CDRKPro/CK-Pro/dozr-3d/boutique/LISEZMOI.md

Page boutique Dozr publiée en artifact. Le modèle 3D (`dozr_web.json`) est celui de `../web/`.
