CDRKPro/CK-Pro/ck-video/VOIX.md

# Texte de la voix off — CK Web Designer (44 s)

Ton : posé, chaleureux, confiant. Environ 2,5 mots par seconde.

| Début | Texte |
|---|---|
| 0:00 | Aujourd'hui, vos futurs clients vous cherchent en ligne. |
| 0:04.6 | Avec CK Web Designer… |
| 0:07.4 | on crée la vitrine digitale de votre entreprise. |
| 0:11.6 | Un site sur mesure, moderne, à votre image. |
| 0:17.0 | Visible sur Google, sur Maps… et même dans ChatGPT. |
| 0:22.6 | Vos visiteurs deviennent des clients. |
| 0:26.4 | Un seul interlocuteur, du début à la fin. |
| 0:30.8 | Site, référencement, maintenance : on s'occupe de tout. |
| 0:35.2 | Envie d'en faire autant ? Réservez votre rendez-vous. |
| 0:39.4 | CK Web Designer. Un site qui vous ressemble. |
