CDRKPro/CK-Pro/ck-video/BRIEF.md

---
workflow: launch
flow: automation
storyboard: no
message: "CK Web Designer crée la vitrine digitale qui fait venir les clients des artisans et commerces."
destination: tiktok-reels
aspect: "9:16"
language: fr
length: ~43s
---

## Intent
Recréer la vidéo de référence (promo Scalyx « Motion design Claude », 16:9 ~38 s) pour CK Web Designer,
aux couleurs et au design de ckwebdesigner.fr. Même déroulé : recherche → logo → vitrine digitale →
réalisations → visible Google/Maps/ChatGPT → visiteurs deviennent clients → preuve → on s'occupe de tout →
CTA rendez-vous → carte de fin.

## Customizations
- Pas de logo/écran TikTok à la fin (demande explicite).
- 9:16 vertical plein écran, sans bandeau titre.
- Scène témoignage « ≈20 prospects » : version sans chiffre, sans faux client → remplacée par la méthode réelle du site (4 étapes).

## Assets
- Captures d'écran du site fournies par Cédric (mobile) : couleurs, polices, textes, prix, réalisations.
- Logo vectorisé depuis la capture (assets/logo.svg).
