CDRKPro/CK-Pro/ck-video/assets/shots/about.jpg

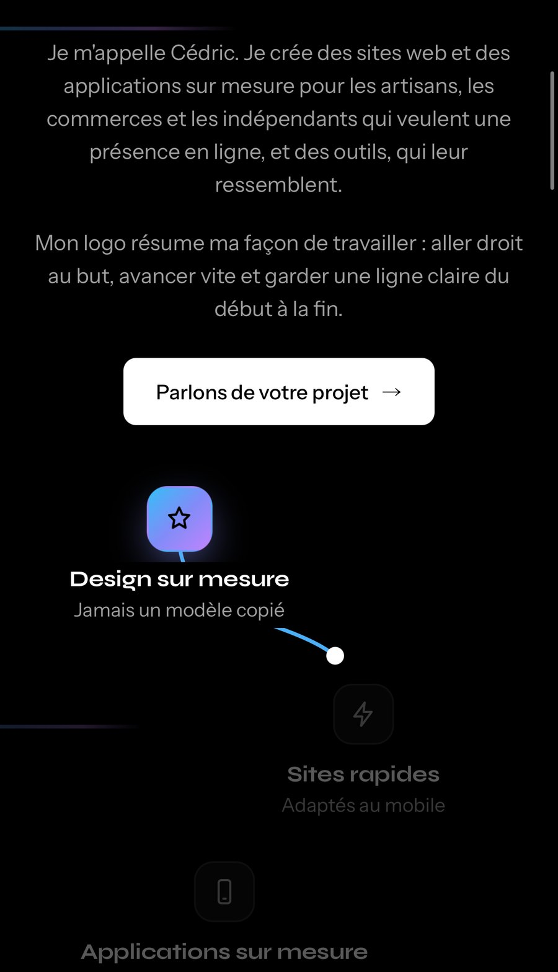
ck-video/assets/shots/about.jpg
