CDRKPro/CK-Pro/ck-video/assets/shots/contact.jpg

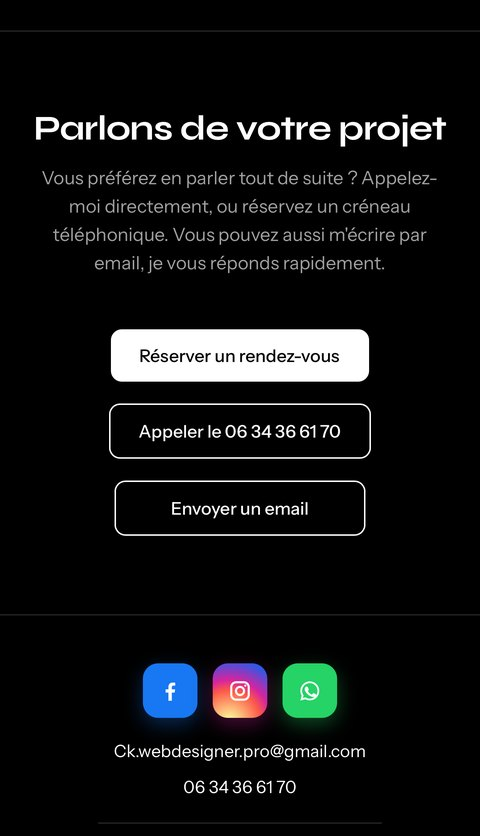
ck-video/assets/shots/contact.jpg
