CDRKPro/CK-Pro/ck-video/assets/shots/demos.jpg

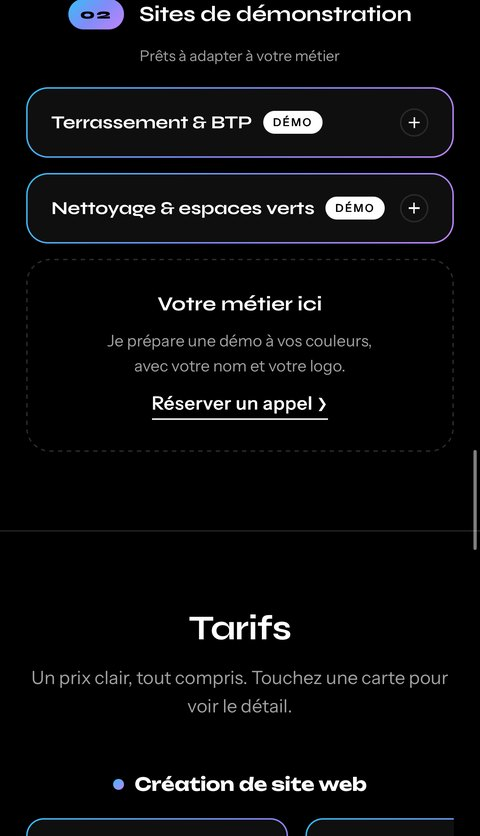
ck-video/assets/shots/demos.jpg
