CDRKPro/CK-Pro/ck-video/assets/shots/estim.jpg

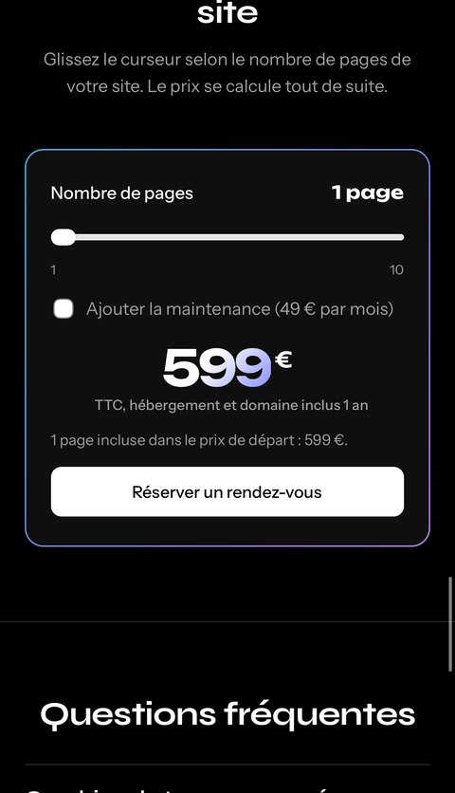
ck-video/assets/shots/estim.jpg
