CDRKPro/CK-Pro/ck-video/assets/shots/form.jpg

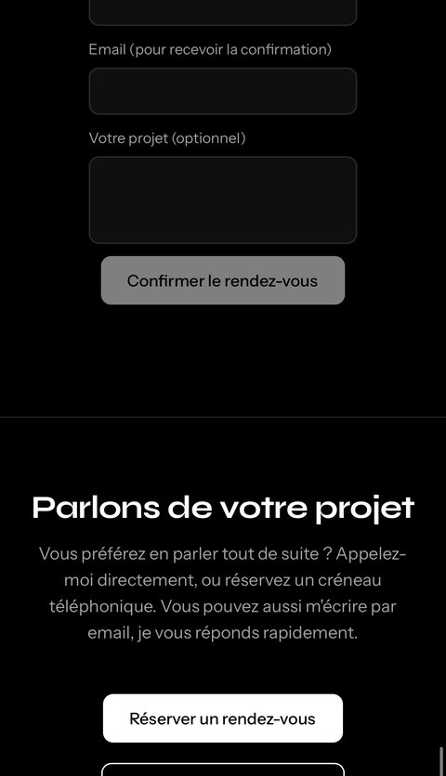
ck-video/assets/shots/form.jpg
