CDRKPro/CK-Pro/ck-video/assets/shots/hero.jpg

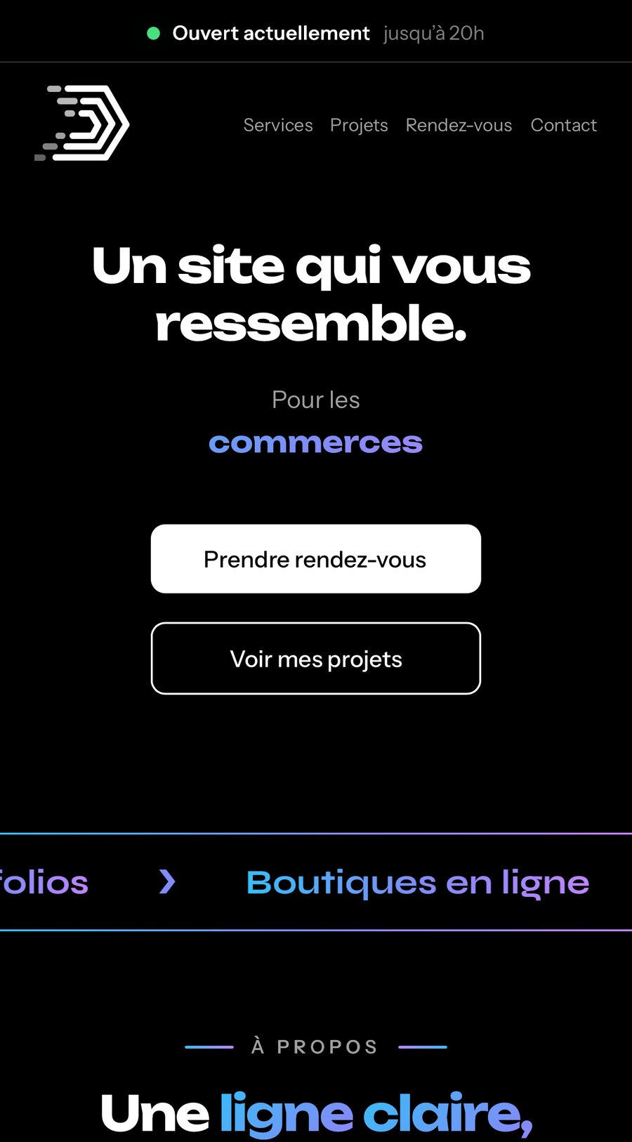
ck-video/assets/shots/hero.jpg
