CDRKPro/CK-Pro/ck-video/assets/shots/method.jpg

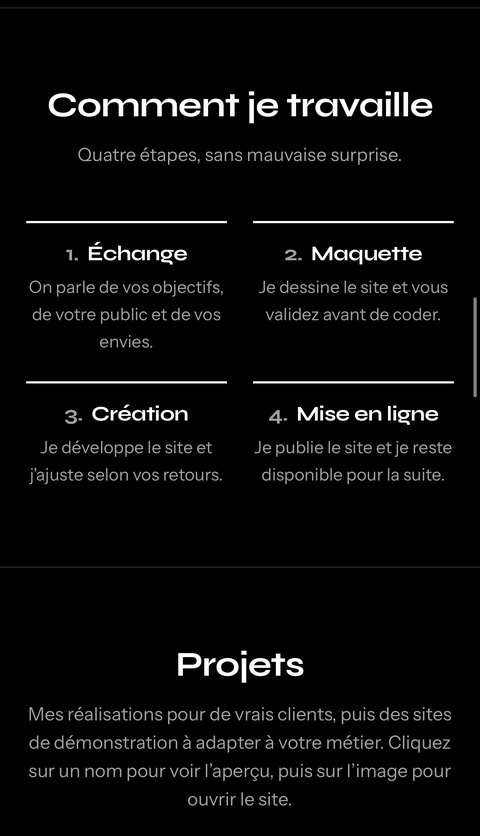
ck-video/assets/shots/method.jpg
