CDRKPro/CK-Pro/ck-video/assets/shots/projets.jpg

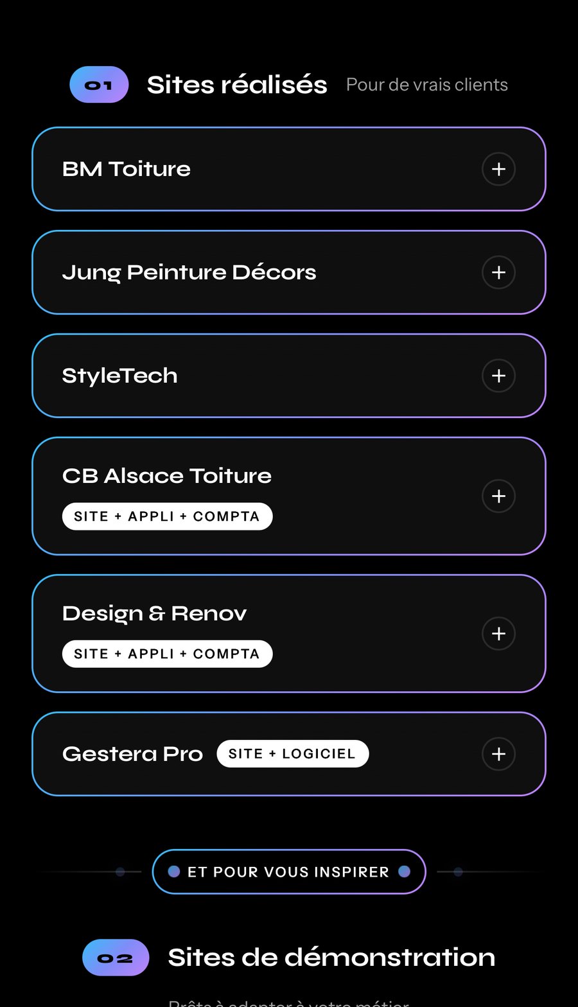
ck-video/assets/shots/projets.jpg
