CDRKPro/CK-Pro/ck-video/assets/shots/rdv.jpg

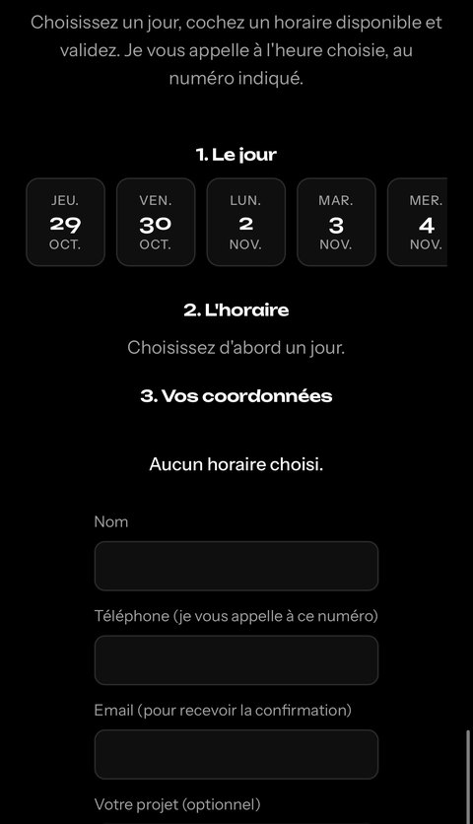
ck-video/assets/shots/rdv.jpg
