CDRKPro/CK-Pro/ck-video/assets/shots/services2.jpg

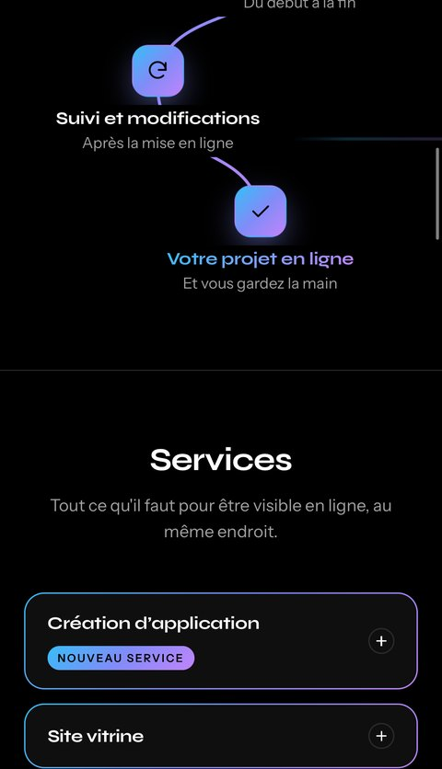
ck-video/assets/shots/services2.jpg
