CDRKPro/CK-Pro/ck-video/assets/shots/services.jpg

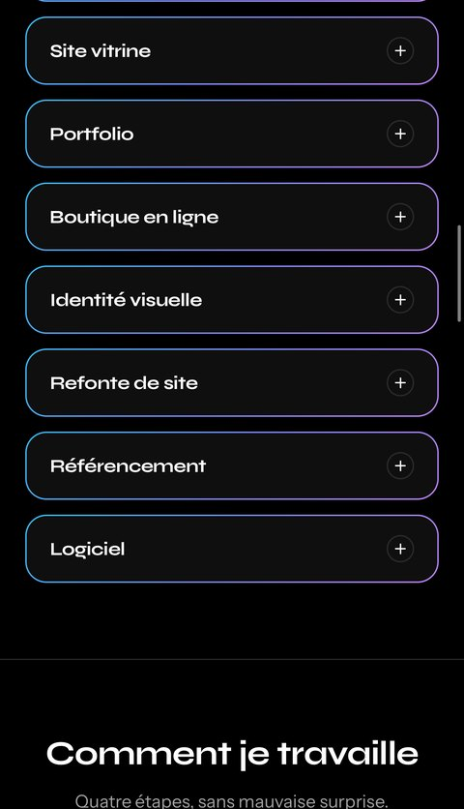
ck-video/assets/shots/services.jpg
