CDRKPro/CK-Pro/ck-video/assets/shots/tarifs2.jpg

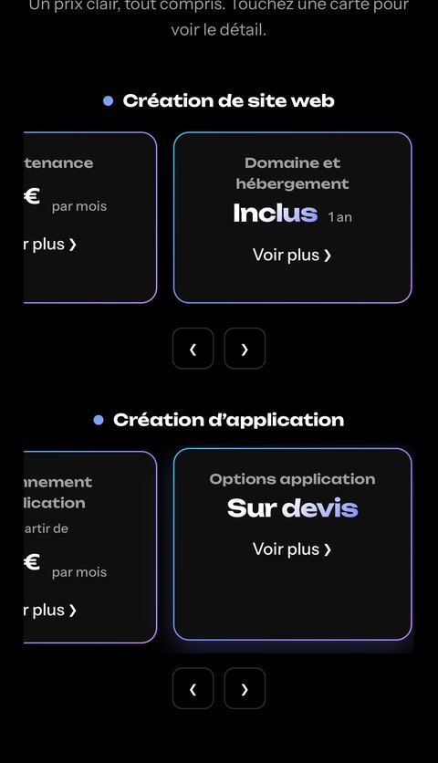
ck-video/assets/shots/tarifs2.jpg
