CDRKPro/CK-Pro/ck-video/assets/shots/tarifs3.jpg

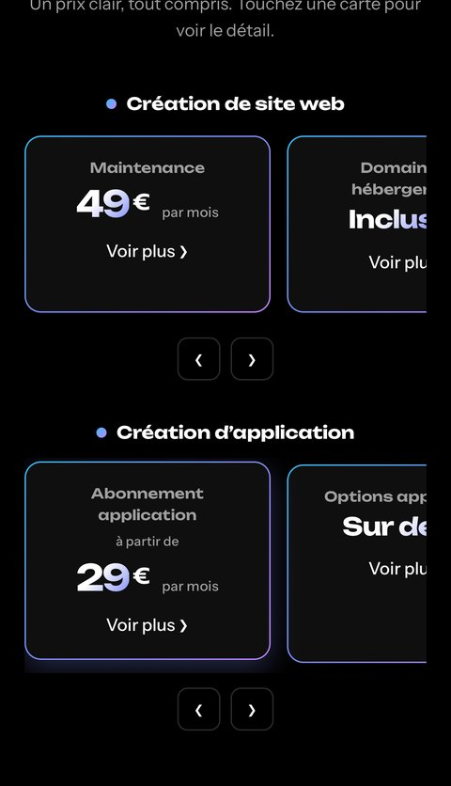
ck-video/assets/shots/tarifs3.jpg
