CDRKPro/CK-Pro/ck-video/assets/shots/tarifs.jpg

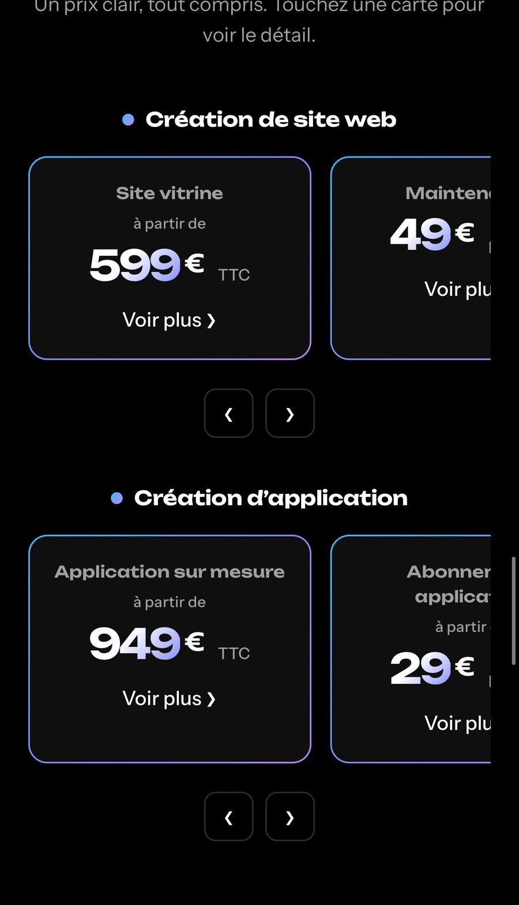
ck-video/assets/shots/tarifs.jpg
