CDRKPro/CK-Pro/ck-video/assets/shots/timeline.jpg

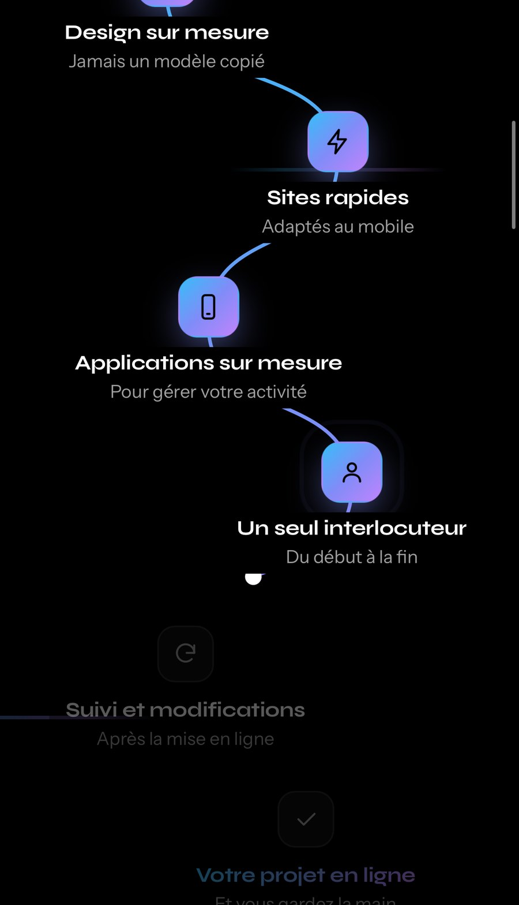
ck-video/assets/shots/timeline.jpg
