CDRKPro/CK-Pro/dozr-3d/boutique/dozr_blanc.png

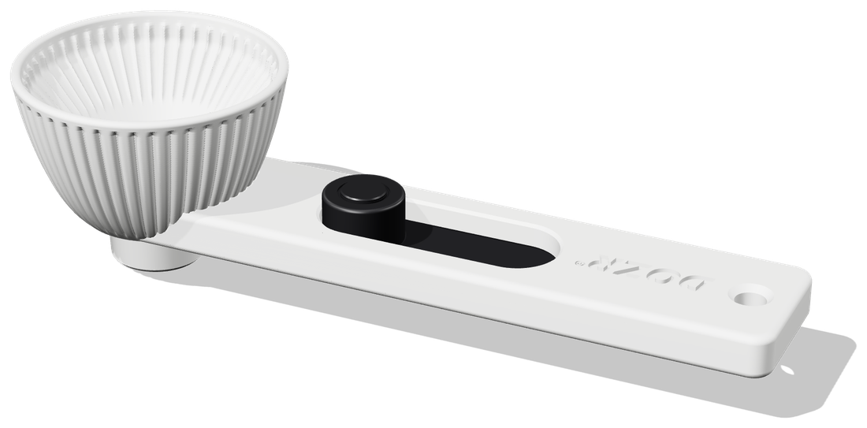
dozr-3d/boutique/dozr_blanc.png
