CDRKPro/CK-Pro/dozr-3d/boutique/dozr_bleu.png

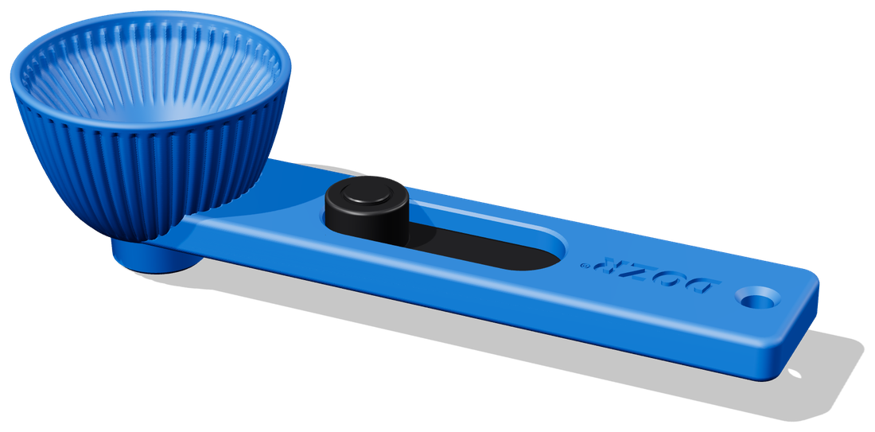
dozr-3d/boutique/dozr_bleu.png
