CDRKPro/CK-Pro/dozr-3d/images/dozr_gamme_couleurs.png

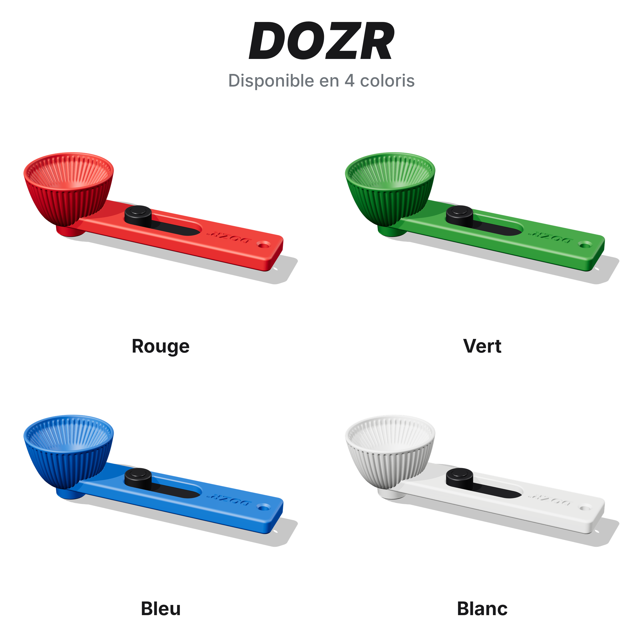
dozr-3d/images/dozr_gamme_couleurs.png
