CDRKPro/CK-Pro/dozr-3d/images/dozr_packshot.png

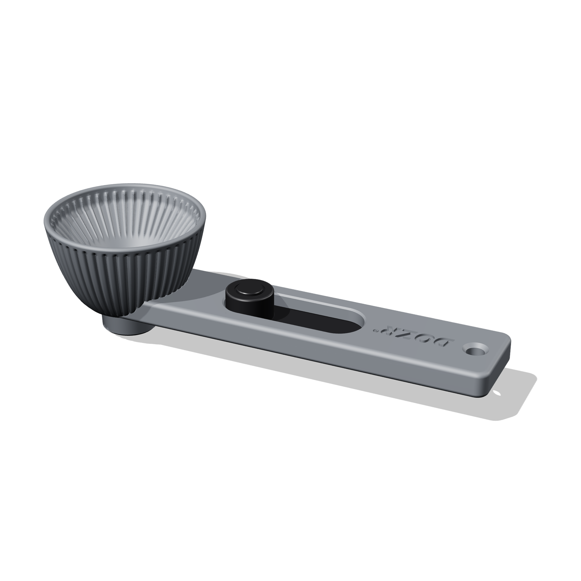
dozr-3d/images/dozr_packshot.png
