CDRKPro/CK-Pro/dozr-3d/images/dozr_visuel.png

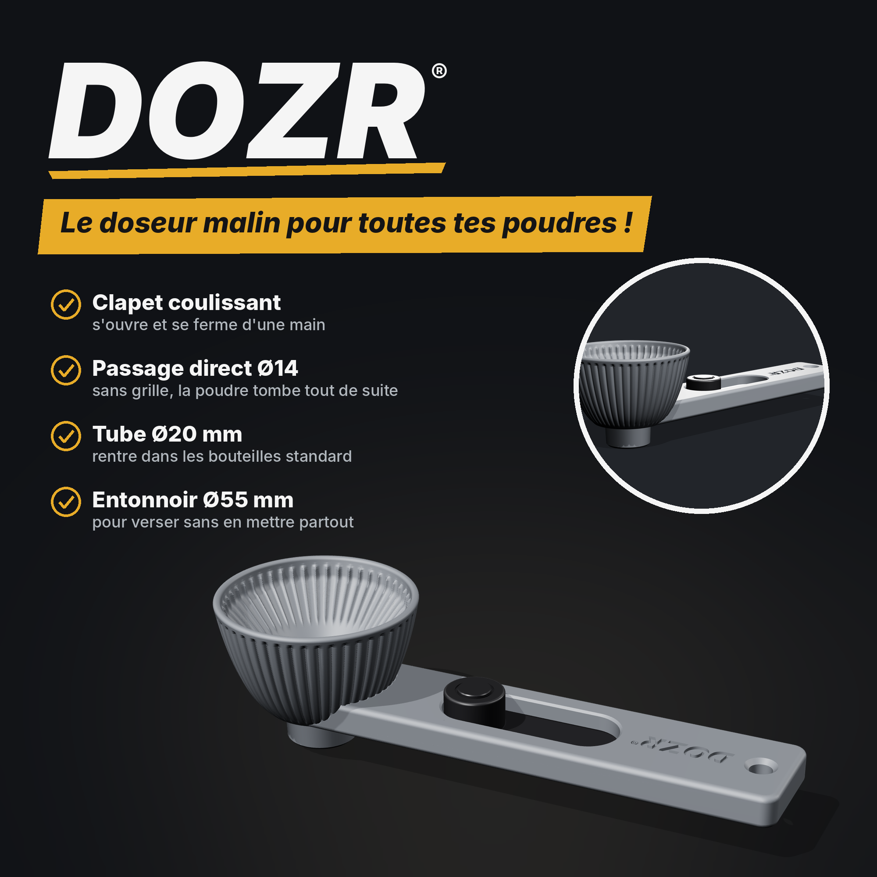
dozr-3d/images/dozr_visuel.png
