CDRKPro/CK-Pro/dozr-3d/plan.png

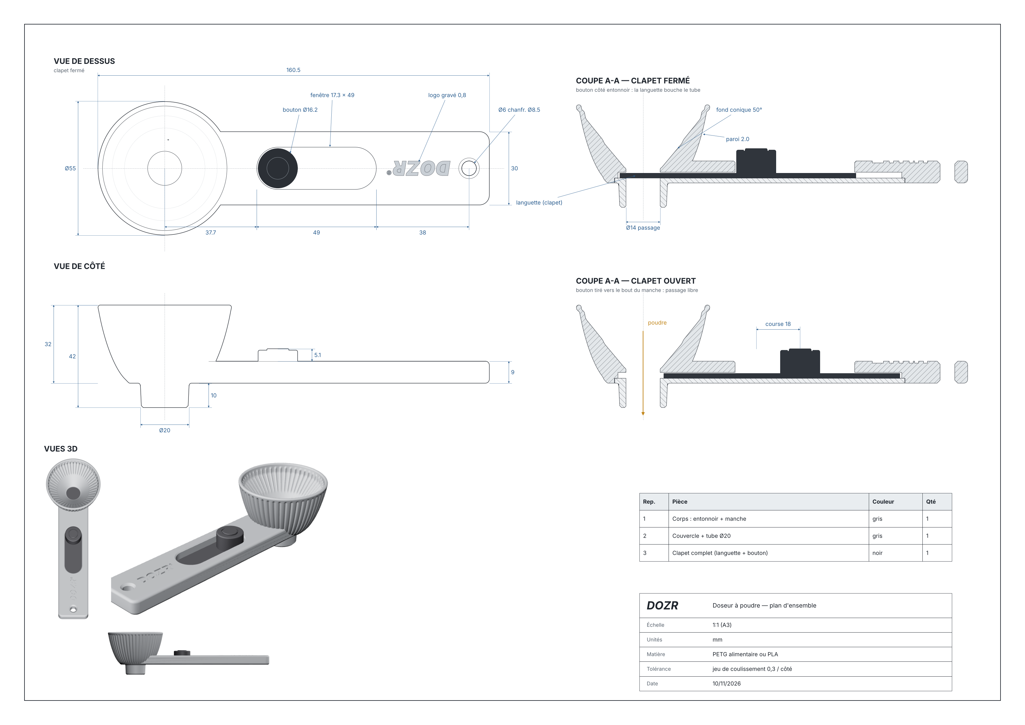
dozr-3d/plan.png
