CDRKPro/CK-Pro/dozr-3d/dozr_assemblage.3mf

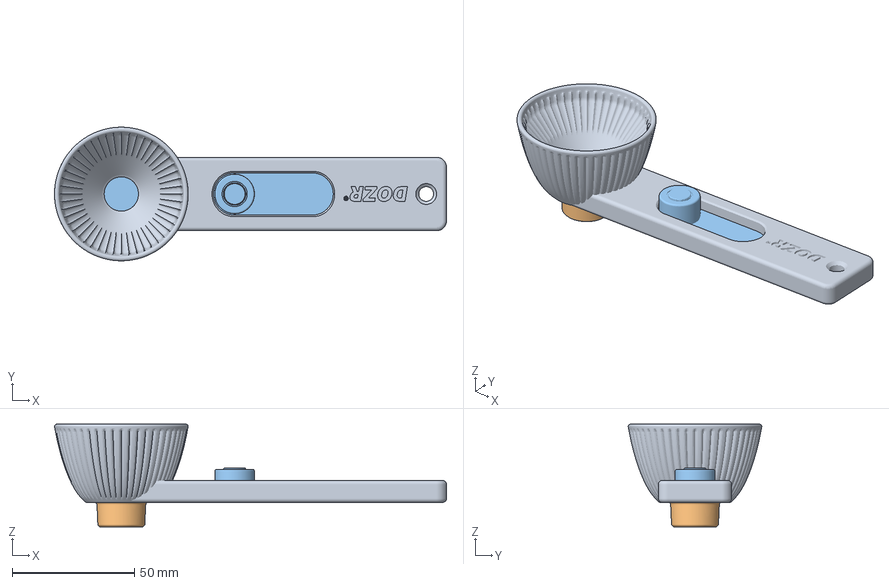
[picture p25: CAD file, 2026-11-10]
dozr-3d/dozr_assemblage.3mf
160.3 x 54.7 x 42.0 mm
corps
couvercle_bec
clapet
