CDRKPro/CK-Pro/dozr-3d/plateau_2_noir.3mf

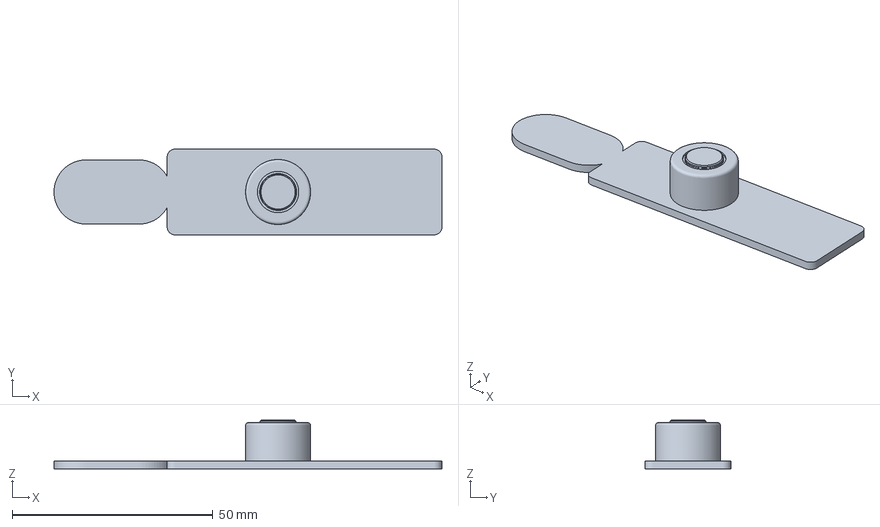
[picture p26: CAD file, 2026-11-10]
dozr-3d/plateau_2_noir.3mf
96.7 x 21.4 x 12.1 mm
