CDRKPro/CK-Pro/dozr-3d/stl/2_couvercle_bec.stl

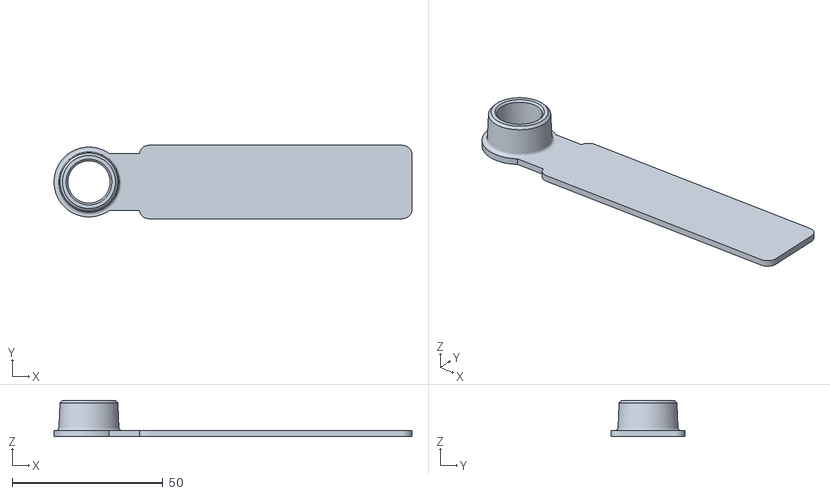
[picture p27: CAD file, 2026-11-10]
dozr-3d/stl/2_couvercle_bec.stl
118.8 x 24.4 x 12.0
