CDRKPro/CK-Pro/dozr-3d/plateau_1_gris.3mf

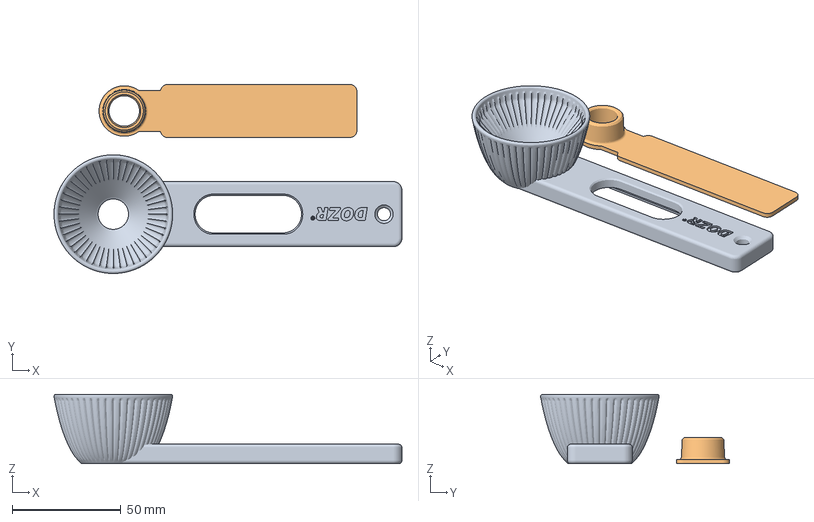
[picture p28: CAD file, 2026-11-10]
dozr-3d/plateau_1_gris.3mf
160.3 x 87.1 x 32.0 mm
1_corps_entonnoir_manche
2_couvercle_bec
