CDRKPro/CK-Pro/dozr-3d/stl/1_corps_entonnoir_manche.stl

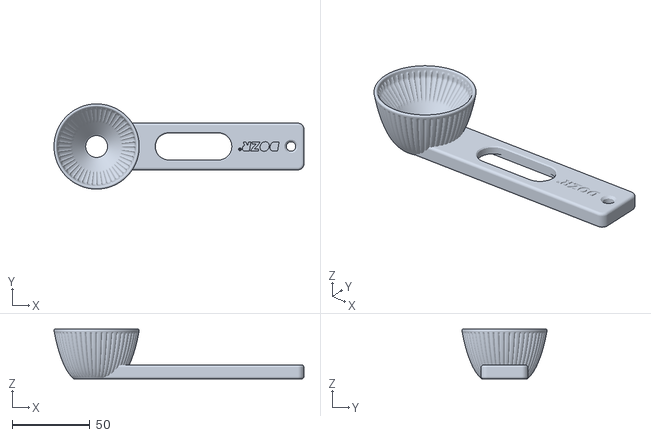
[picture p29: CAD file, 2026-11-10]
dozr-3d/stl/1_corps_entonnoir_manche.stl
160.3 x 54.7 x 32.0
