CDRKPro/CK-Pro/dozr-3d/plateau_complet_multicolore.3mf

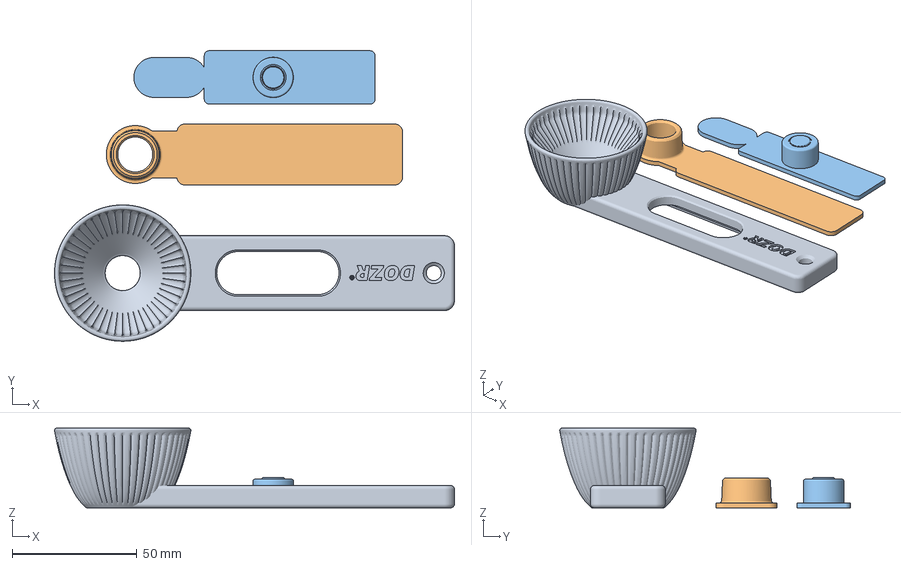
[picture p30: CAD file, 2026-11-10]
dozr-3d/plateau_complet_multicolore.3mf
160.3 x 116.5 x 32.0 mm
1_corps_entonnoir_manche
2_couvercle_bec
3_clapet_complet
