CDRKPro/CK-Pro/(list of files, cad)

Other CAD files:
dozr-3d/stl/3_clapet_complet.stl
dozr-3d/dozr_assemblage.stl
