CDRKPro/CK-Pro/ck-video/assets/shots/faq.jpg

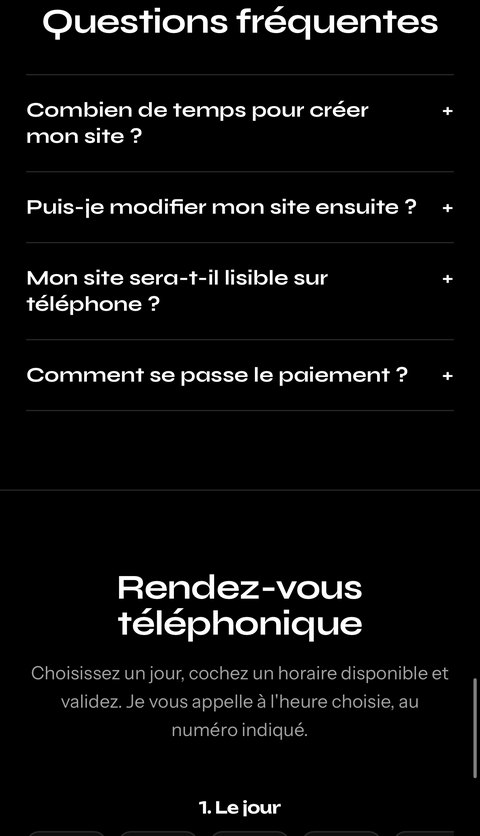
ck-video/assets/shots/faq.jpg
