CDRKPro/CK-Pro/dozr-3d/plan.pdf

## VUE DE DESSUS

## COUPE A-A — CLAPET FERMÉ

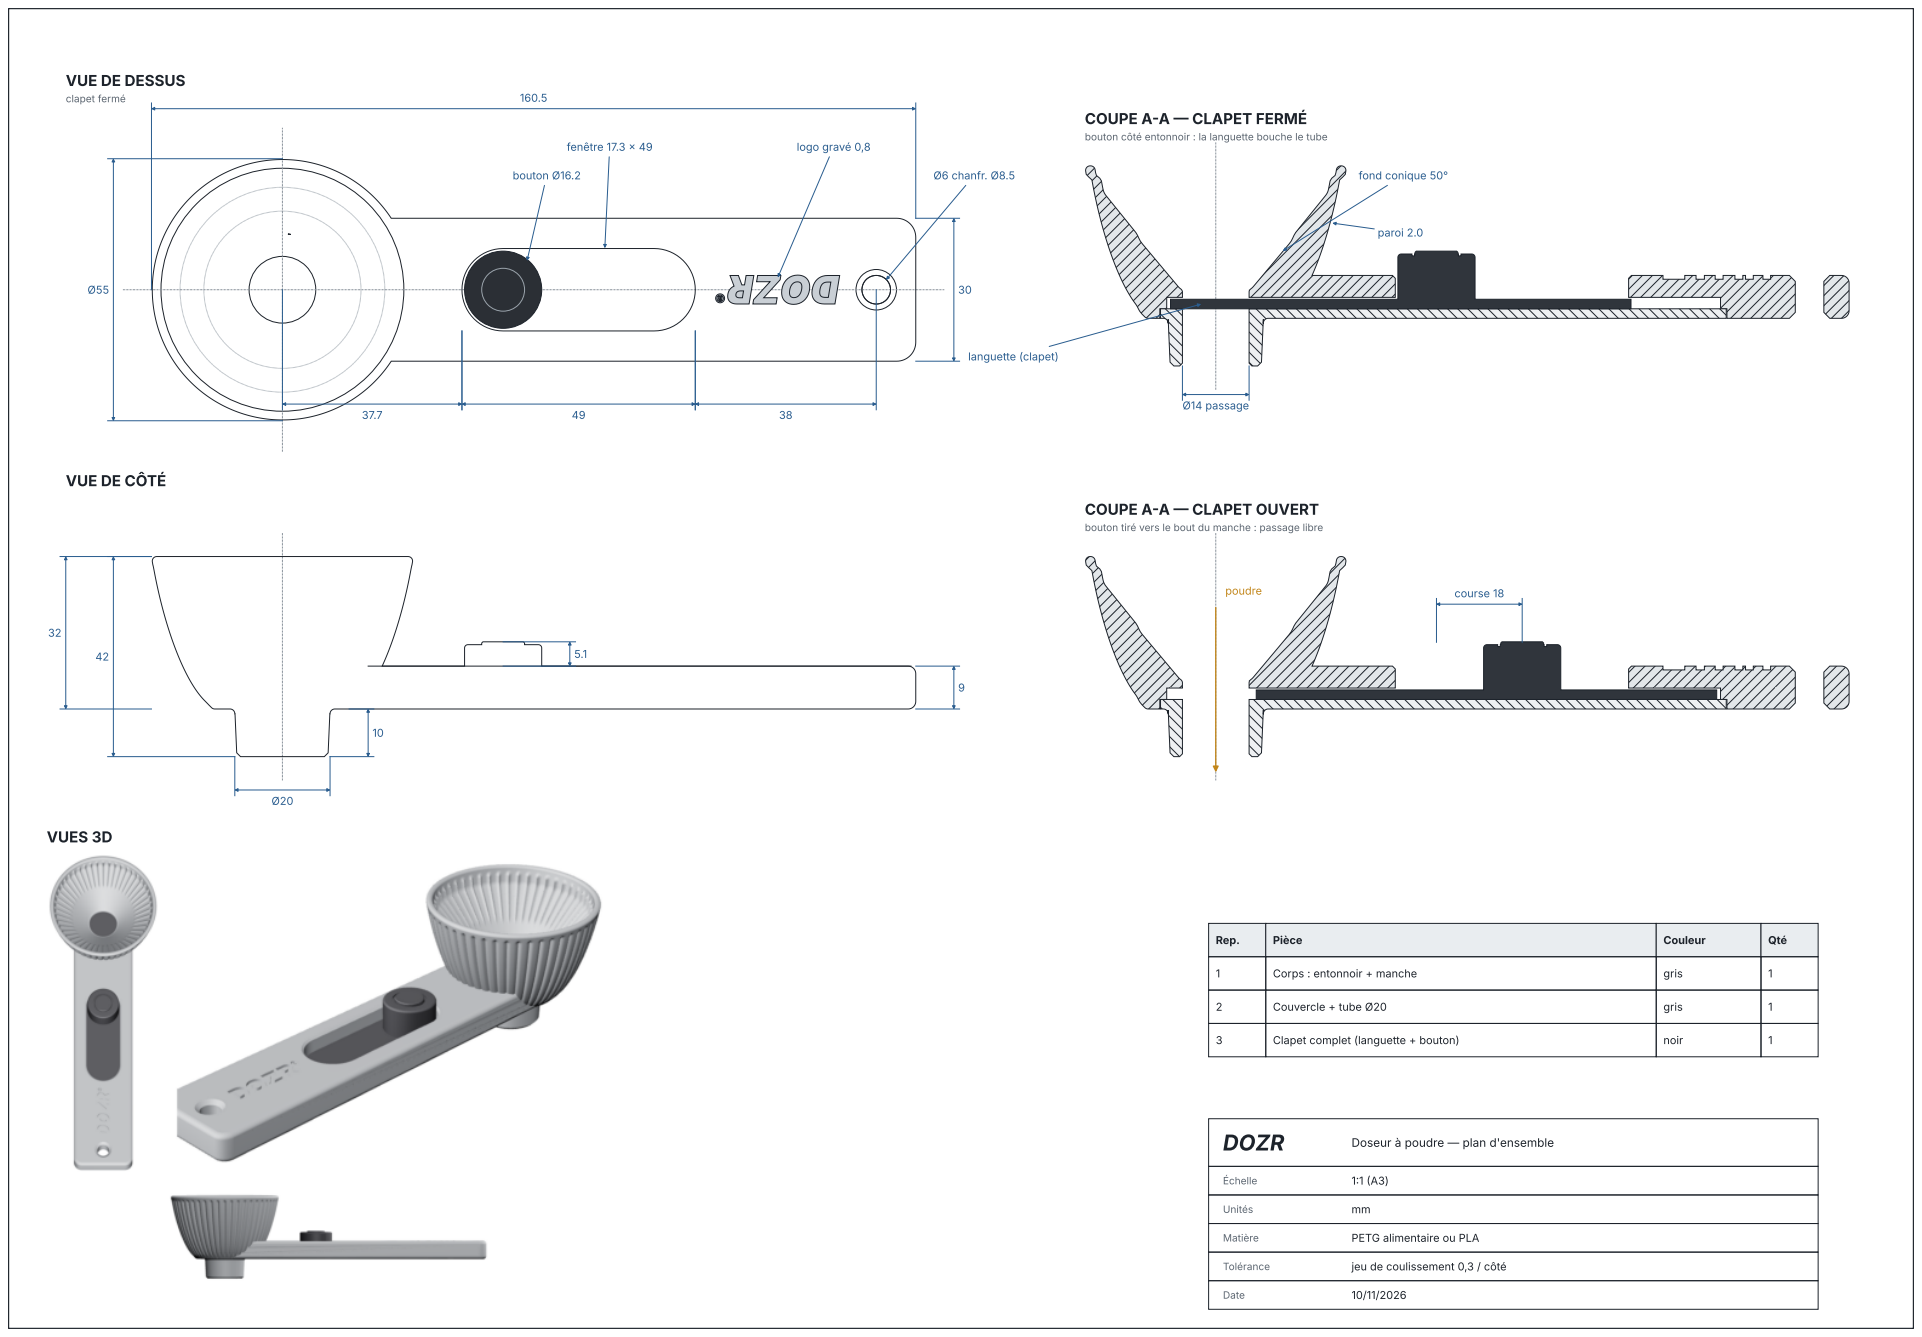
[picture p32: page 1]
clapet fermé; bouton Ø16.2; Ø6 chanfr. Ø8.5; fenêtre 17.3 × 49; logo gravé 0,8; Ø14 passage; fond conique 50°; languette (clapet); paroi 2.0; poudre; course 18; VUES 3D; Rep.; Pièce; Couleur; Qté; Corps : entonnoir + manche; gris; Couvercle + tube Ø20; Clapet complet (languette + bouton); noir; DOZR; Doseur à poudre — plan d'ensemble; Échelle; Unités; Matière; PETG alimentaire ou PLA; Tolérance; jeu de coulissement 0,3 / côté; Date

bouton côté entonnoir : la languette bouche le tube

VUE DE CÔTÉ

COUPE A-A — CLAPET OUVERT

bouton tiré vers le bout du manche : passage libre
