CDRKPro/CK-Pro/(commit log)

2026-10-26 Add Funding Pro prop-firm landing page
    Single-file static page: hero with account dashboard mock, stats,
    interactive challenge picker, steps, features, payout feed,
    sample testimonials, FAQ and footer with risk disclaimer.
    Claude-Session: https://claude.ai/code/session_01TbBw8k7q31zmcosYMwTQGu
2026-11-10 Ajoute le modèle 3D imprimable du doseur Dozr
    Modèle paramétrique (Python + manifold3d) en 5 pièces : corps inférieur avec bec,
    entonnoir cannelé, trappe coulissante, bouton et tamis. STL orientés pour
    l'impression, assemblage 3MF/GLB/STL et notice.
    Claude-Session: https://claude.ai/code/session_013o4PzjrureLHbsufY6pFN3
    [1_corps_inferieur.stl, 2_corps_superieur_entonnoir.stl, 3_trappe_coulissante.stl, 4_bouton.stl, 5_tamis.stl, dozr_assemblage.3mf, dozr_assemblage.stl]
2026-11-10 Dozr : reprend la forme exacte du visuel produit
    Entonnoir évasé cannelé dehors et dedans avec fond arrondi, tamis rond
    affleurant, manche plat 30 mm avec pilule noire et bouton rond côté
    entonnoir, trou de suspension. Languette coulissante cachée sous le fond.
    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
    [1_corps_inferieur.stl, 2_corps_superieur_entonnoir.stl, 3_languette.stl, 3_trappe_coulissante.stl, 4_bouton.stl, 5_tamis.stl, 6_insert_noir.stl, dozr_assemblage.3mf]
2026-11-10 Dozr : modèle calqué sur les vues de face et 3/4
    Proportions relevées sur la vue de face (manche 30 mm, longueur 160,5 mm,
    pilule 17,3 x 49 mm, bouton Ø16 à disque central, trou chanfreiné), profil
    d'après la vue 3/4 : entonnoir Ø55 x 28 à fond très arrondi cannelé dedans
    et dehors, fond plat posé sur le goulot (bec en option).
    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
    [1_corps_inferieur.stl, 2_corps_superieur_entonnoir.stl, 3_languette.stl, 4_bouton.stl, 5_tamis.stl, 6_insert_noir.stl, dozr_assemblage.3mf, dozr_assemblage.stl]
2026-11-10 Dozr : entonnoir conique, bec de 10 mm et corps d'une seule pièce
    Entonnoir conique vers le bas (Ø55 -> Ø34) à côtes bombées et bandeau lisse
    sous une lèvre arrondie, bec Ø20 x 10 mm pour goulot standard, entonnoir et
    manche fusionnés en une pièce sans joint visible, arêtes du manche
    réellement arrondies. La languette se monte par dessous, fermée par le
    couvercle qui porte le bec.
    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
    [1_corps_entonnoir_manche.stl, 1_corps_inferieur.stl, 2_corps_superieur_entonnoir.stl, 2_couvercle_bec.stl, 3_languette.stl, 4_bouton.stl, 6_insert_noir.stl, dozr_assemblage.3mf]
2026-11-10 Dozr : entonnoir en bol conique d'après le croquis de profil
    Paroi presque verticale en haut qui s'arrondit en se resserrant jusqu'au
    tube Ø20 x 10 mm (mélange quart d'ellipse / cône, réglable par BOWL).
    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
    [1_corps_entonnoir_manche.stl, 2_couvercle_bec.stl, dozr_assemblage.3mf, dozr_assemblage.stl]
2026-11-10 Dozr : passage direct sans grille et logo DOZR gravé sur le manche
    Suppression du tamis : le fond de l'entonnoir descend à 50° jusqu'au trou
    Ø14, la poudre tombe dès l'ouverture du clapet. Logo « DOZR® » gravé en
    creux (Inter Black Italic, OFL) entre la pilule et le trou de suspension.
    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
    [1_corps_entonnoir_manche.stl, 5_insert_noir.stl, 5_tamis.stl, dozr_assemblage.3mf, dozr_assemblage.stl]
2026-11-10 Dozr : clapet complet d'une seule pièce d'après les croquis
    Le clapet est une pièce noire unique : languette qui passe entre
    l'entonnoir et le tube, semelle retenue dans le canal du manche, pilule
    visible dans une fenêtre traversante et bouton. Bouton côté entonnoir =
    tube fermé ; tiré de 18 mm = tube entièrement dégagé. Plus que 3 pièces.
    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
    [1_corps_entonnoir_manche.stl, 2_couvercle_bec.stl, 3_clapet_complet.stl, 3_languette.stl, 4_bouton.stl, 5_insert_noir.stl, dozr_assemblage.3mf, dozr_assemblage.stl]
2026-11-10 Dozr : seul le bouton dépasse du clapet
    Suppression de la pilule surélevée derrière le bouton : le fût du bouton
    descend directement jusqu'à la semelle du clapet.
    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
    [3_clapet_complet.stl, dozr_assemblage.3mf, dozr_assemblage.stl]
2026-11-10 Dozr : dossier d'impression complet
    Chanfrein à 45° sous le bol (2 mm) pour imprimer sans support, plateaux
    3MF prêts à trancher (gris, noir, multicolore) sur 180 x 180 mm, guide
    d'impression avec réglages et montage, archive zip de tous les fichiers.
    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
    [1_corps_entonnoir_manche.stl, dozr_assemblage.3mf, dozr_assemblage.stl, plateau_1_gris.3mf, plateau_2_noir.3mf, plateau_complet_multicolore.3mf]
2026-11-10 Dozr : plan coté A3 1:1 et maquette 3D web
    plan.py génère depuis le modèle le plan d'ensemble (vue de dessus, vue de
    côté, coupes clapet fermé/ouvert, nomenclature, cartouche) en PDF/SVG/PNG
    et un glTF pour la page web interactive (clapet ouvrable, vue éclatée).
    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
2026-11-10 Dozr : la vue 3D web décode le modèle elle-même
    L'hébergement des pages interdit de charger des URI data:, ce qui
    bloquait le chargement du glTF. La page décode les tampons base64 et
    assemble un GLB en mémoire avant de l'afficher.
    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
2026-11-10 Dozr : fenêtre du clapet entièrement noire, sans trou
    La semelle large du clapet est prolongée vers l'avant de la course : la
    fenêtre du manche est couverte d'une surface noire continue, clapet ouvert
    comme fermé. Plan, rendus, plateaux et vue 3D régénérés.
    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
    [1_corps_entonnoir_manche.stl, 2_couvercle_bec.stl, 3_clapet_complet.stl, dozr_assemblage.3mf, dozr_assemblage.stl, plateau_1_gris.3mf, plateau_2_noir.3mf, plateau_complet_multicolore.3mf]
2026-11-10 Dozr : images produit (packshot, visuel marketing, détouré)
    Rendus du vrai modèle 3D : packshot fond blanc 2000 px, visuel marketing
    fond sombre avec logo, accroche et arguments tirés des cotes, et version
    détourée à fond transparent. images_produit.py compose les visuels.
    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
2026-11-10 Dozr : images produit en rouge, vert, bleu et blanc
    Packshot, visuel marketing et détouré pour chaque coloris (clapet noir),
    image de gamme 2 x 2 et archive zip de toutes les images.
    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
2026-11-10 Dozr : page boutique avec rendus 3D, 5 coloris et vue 3D
    Image principale et pastilles synchronisées sur 5 coloris, section des
    coloris, vue 3D interactive (rotation, clapet ouvrable, couleur au choix,
    sans vue éclatée) chargée à l'arrivée sur la section.
    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
2026-11-10 Dozr boutique : vue 3D en haut de page, section coloris retirée
    La vue 3D remplace l'image fixe du haut (l'image sert d'aperçu pendant le
    chargement), pilotée par les pastilles de couleur. Glisser horizontalement
    fait tourner, le défilement vertical et la molette restent libres.
    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
2026-11-10 Dozr : vue 3D immédiate et modèle web allégé (12,3 -> 2,8 Mo)
    Profil de l'entonnoir simplifié à 0,01 mm pour le web seulement (STL
    d'impression inchangés). La boutique lance la 3D dès l'ouverture, sans
    attendre la fin du chargement de la page, avec un pourcentage de progression.
    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
    [dozr_assemblage.3mf, plateau_1_gris.3mf, plateau_2_noir.3mf, plateau_complet_multicolore.3mf]
2026-11-10 Dozr : boutique prête pour Netlify avec panier et paiement Stripe
    Page unique (index.html, modèle 3D intégré) : accent vert seul, fond
    graphite pro, texte d'abord puis « Visualise-le ici » avec la 3D et les
    coloris attachés, bloc d'achat, vraie page panier ouverte à l'ajout
    (quantités, livraison offerte dès 2, total), paiement Stripe Checkout via
    une fonction Netlify qui garde la clé secrète et recalcule les prix.
    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
2026-11-10 Dozr boutique : prix à 8,90 € (packs 15,90 € et 21,90 €)
    Prix mis à jour à l'identique dans la page et dans la fonction de
    paiement Stripe.
    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
2026-11-10 Dozr : page de statistiques des ventes (Stripe)
    stats.html + fonction Netlify stats.mjs protégée par STATS_TOKEN : chiffre
    d'affaires, commandes, panier moyen, DOZR vendus, ventes par jour, coloris,
    packs, pays et dernières commandes, lus en lecture seule dans Stripe.
    Données d'exemple sans token.
    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
2026-11-10 Dozr : page de stats au visuel Solera avec suivi des visites
    stats.html reprend la mise en page de Solera Stats aux couleurs DOZR
    (connexion par mot de passe, visiteurs en direct, paniers actifs, paiements
    en cours, 8 indicateurs, parcours, graphiques, sources, commandes).
    Nouvelle fonction suivi.mjs (Netlify Blobs) alimentée par la boutique ;
    stats.mjs combine ces visites avec les commandes Stripe ; la source de la
    visite est enregistrée dans les métadonnées du paiement.
    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
